jewel-nath/robot-niko/docs/report/robot-niko-report.pdf

Technical report | · Version 1.1 | · October 2026

## Robot Niko: A Life-Size 3D-Printed Humanoid Assistant on a Raspberry Pi

System Design and Build

Jewel Nath¹,2
, Shanjit Mondol²

, Tousif Bin Parves²

, Md Mohiuddin Khan Mahin² ,
Anik Chakraborty²

1

Independent researcher, Dhaka, Bangladesh 2Quanta Robotics, Comilla University, Cumilla, Bangladesh Jewel Nath: ORCID 0009-0002-6609-6378 (https://orcid.org/0009-0002-6609-6378) · Code: https://github.com/jewel-nath/robot-niko

Licence: CC BY 4.0 (https://creativecommons.org/licenses/by/4.0/)

Abstract
Niko is a life-size humanoid assistant built in 2022 by Quanta Robotics, a student robotics team at Comilla University, at the FabLab of the Deputy Commissioner’s Office in Cumilla, Bangladesh. Its body follows InMoov, the open-source 3D-printed humanoid: a head, torso, two arms and two five-fingered hands, on a stand over a wheeled base.

Where InMoov is usually run by Arduino boards and the MyRobotLab framework, Niko runs from a single Raspberry Pi 4 with its own Python software. Two PCA9685 boards drive its 27 servos, addressed as one set of channels and moved through a library of gestures written as timed sequences of joint angles. A wake word, “Hey Niko”, runs on the robot; an online assistant transcribes speech; and Niko answers questions about itself and its host from its own bank (51 questions in 152 phrasings in the published code), in its own voice, its jaw moving as it speaks. A camera lets it turn its head toward a face, and recognise people it has been taught, greeting each one by name with a handshake.

Niko was launched in public on 6 December 2022, and was reported by six news outlets and interviewed on national television. This report describes its mechanical build, electronics, software architecture, motion, voice and vision, documents the behaviours shown on video, and sets out the lessons and the next steps.

Keywords: humanoid robots, social robots, InMoov, 3D printing, Raspberry Pi, servo control, wake word, face recognition, human–robot interaction.

### 1 Introduction

Robots that meet people face to face, greet them and answer their questions are an established line of research in social robotics [1, 2]. A robot receptionist that greets visitors and talks with them [3] and mass-produced humanoids such as NAO and Pepper [4, 5] have shown what such robots can do, but commercial platforms remain out of reach for most student teams.

Open-source, 3D-printed designs have changed that. InMoov [6] and Poppy [7] publish every part of a

Robot Niko: system design and build | Technical report, v1.1, October 2026

humanoid body, printable on a home printer. A body, however, is only half of a robot: it still needs the electronics and software that make it see, speak and move.

Niko was built to show that a student team could take an open design to a working, life-size assistant in under a year, with one low-cost computer and its own software. Its job was to greet visitors to the FabLab, answer their questions about the robot and its host, and recognise the people it knows (Fig. 1).

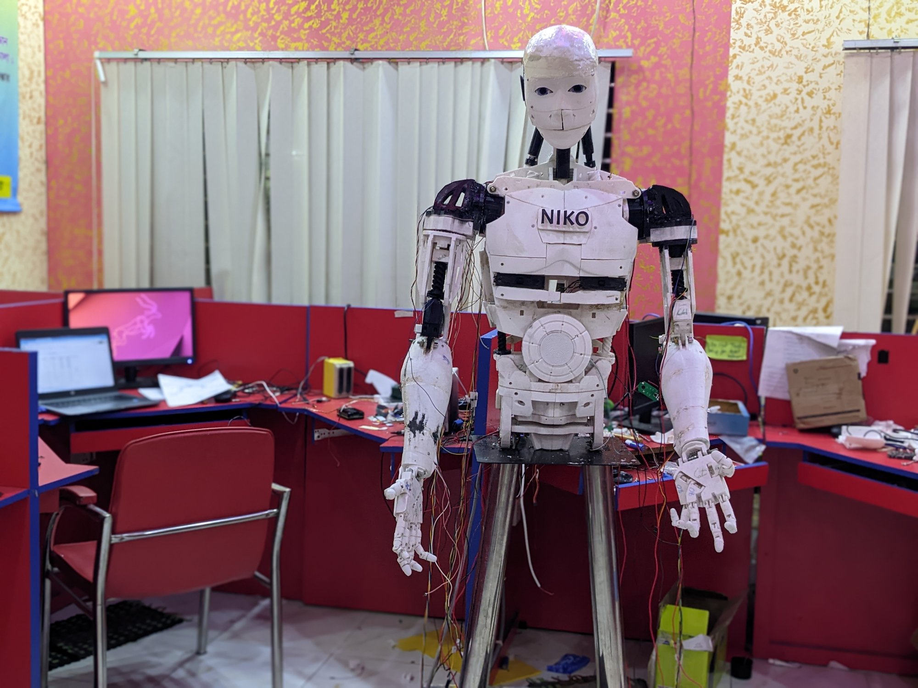
[picture p14: figure]
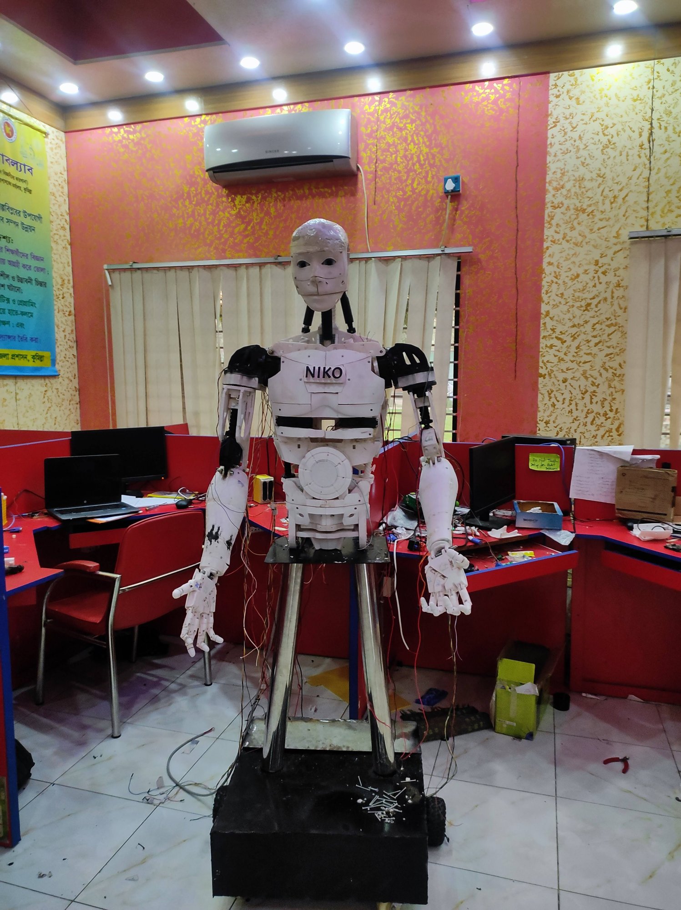
[picture p15: figure]

Figure 1: Niko, finished, on 29 November 2022: the InMoov head, torso, arms and hands on a metal stand (left), and the stand on its wheeled base in the FabLab (right).

This report describes Niko as built, and contributes:

1. a complete InMoov upper body built and run from a single Raspberry Pi, in Python, in place of the usual Arduino boards and MyRobotLab (Sections 4–6);
2. a motion layer that drives 27 servos on two boards as one set of channels, with a library of gestures, from a handshake to counting on its fingers (Section 7);
3. a voice pipeline that combines an on-device wake word, an online assistant and Niko’s own bank of answers, with a jaw that moves as it speaks (Section 8);
4. vision that turns the head toward a face and greets known people by name with a handshake (Section 9);
5. the behaviours shown on video, and the open source code, under the MIT licence; files derived from other projects keep their own licences [8] (Section 10).

Results at a glance

What Niko does | How | Evidence
Follows a face with its head | OpenCV face detection steers the head servo | shown on video
Greets people by name | face recognition, then a spoken greeting and a handshake | shown on video
Holds spoken conversations | wake word, online assistant, its own question bank | shown on video
Introduces itself | a launch speech in seven parts | shown on video
Moves on its wheeled base | a two-motor base under the stand | shown on video
Moves 27 joints | head, eyes, jaw, shoulders, arms, wrists and fin- gers | in the code
Makes hand gestures | handshake (used in greetings); thumbs up, point- ing, counting and more in the library | in the code
Starts by itself | a systemd service starts and restarts it | in the code

Videos recorded on 6 and 7 December 2022 at the FabLab; two are public: the head following a face (https://youtu.be/6iEj3AY1AlA) and Niko introducing itself. (https://youtu.be/Iotg0E8AKoU)

### 2 Related Work

Social robots. Fong et al. survey robots built to interact with people [1], and Breazeal sets out what makes a robot sociable [2]. Gockley et al. placed a robot receptionist with a scripted character in a university building, for long-term interaction with the people who passed it [3]. Niko shared that setting: it lived in one place, greets the people it knows and answers questions about its host.

Humanoid platforms. NAO [4] and Pepper [5] are the best-known commercial humanoids for interaction, and iCub [9] is an open platform for research in embodied cognition. InMoov [6], begun by Gaël Langevin in 2012, and the Poppy project [7] made life-size and smaller humanoids printable at home. In-Moov is usually run by Arduino boards under MyRobotLab [10]; Niko keeps InMoov’s body and replaces its control with a Raspberry Pi and its own code.

Perception. Niko’s face detector is the boosted cascade of Viola and Jones [11], as implemented in OpenCV [12]. Its face recognition uses the face_recognition library [13], built on dlib [14]: faces are aligned with landmarks found by regression trees [15], encoded by a residual network [16] into an embedding in the spirit of FaceNet [17], and classified by nearest neighbours [18] with scikit-learn [19].

Voice. The voice program began from GassistPi [20], an open voice assistant for single-board computers, and uses Picovoice’s Porcupine [21] for an on-device wake word.

### 3 System Overview

Fig. 2 shows the whole robot. A Raspberry Pi 4 runs every program. It drives the servos over I²C through two PCA9685 boards, hears and speaks through a USB sound card, sees through a USB camera on the chest, and signals its state with two lights. Online services, reached over the internet, transcribe speech

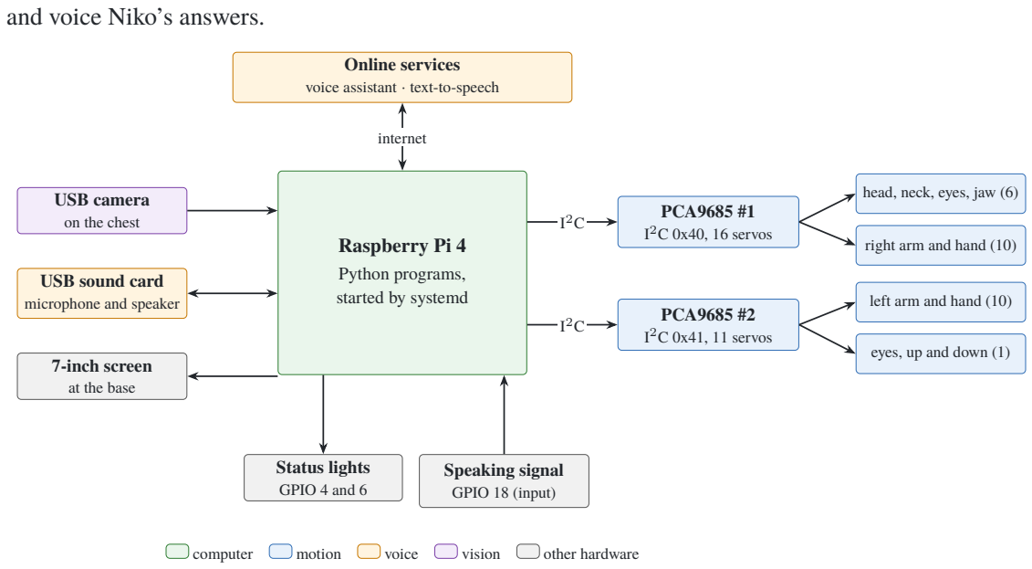
[picture p16: figure]
and voice Niko’s answers.; Raspberry Pi 4; Python programs, started by systemd; Online services voice assistant · text-to-speech; USB camera on the chest; USB sound card microphone and speaker; 7-inch screen at the base; PCA9685 #1; 2C 0x40, 16 servos; PCA9685 #2; 2C 0x41, 11 servos; head, neck, eyes, jaw (6); right arm and hand (10); left arm and hand (10); eyes, up and down (1); Status lights GPIO 4 and 6; Speaking signal GPIO 18 (input); internet; computer; motion; voice; vision; other hardware

Figure 2: System overview. One Raspberry Pi (green) runs the programs; two PCA9685 boards
drive the 27 servos (blue); voice (orange) and vision (purple) devices connect over USB.

The design rests on two choices. First, one computer does everything: there is no microcontroller between the Pi and the servos, only the PCA9685 boards, which generate the pulses on their own once set. Second, the question bank is kept out of the code, in a YAML file: teaching Niko a new answer is an edit to a file, not to the program. The servo map, the channel and starting angle of every joint, is written down in a second YAML file, and the moves use the same numbers.

### 4 Mechanical Build

Niko is InMoov’s head, torso, arms and hands [6]. InMoov’s parts are designed to print on a printer with a 12 × 12 × 12 cm bed; its fingers are pulled by tendons from servos in the forearm. Niko’s eyes move in two axes, its jaw opens and closes, its neck is moved by three servos, and each arm has a shoulder, an omoplate (shoulder blade), an arm rotation, a bicep, a wrist and five fingers. The upper body stands on a metal stand, and the stand on a wheeled base with two motors.

In August 2022 the team assembled a 3D model of Niko from InMoov’s parts in Blender, with “NIKO” on its chest, and posed its joints. The first printed parts in the photos date from mid-August, and the robot was assembled in November (Figs. 3 and 4).

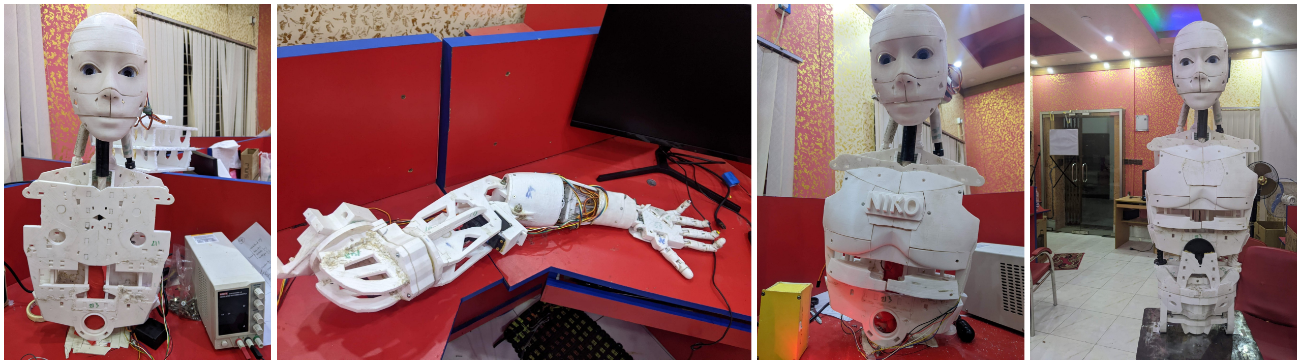
[picture p17: figure]

Figure 3: The build in November 2022, in order: the head on its frame, its eyes in (2 November); one arm and hand, printed and wired (2 November); the head on the chest, “NIKO” printed on it (8 November); the head on the assembled torso (23 November).

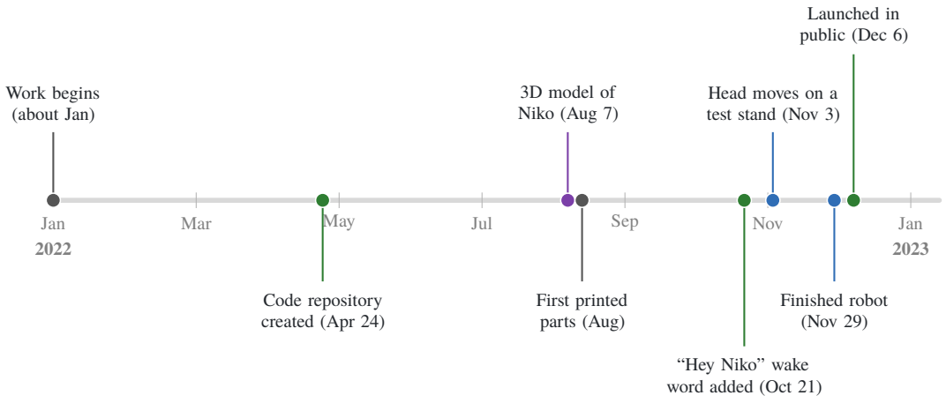
[picture p18: figure]
Jan; Mar; May; Jul; Sep; Nov; Work begins (about Jan); 3D model of Niko (Aug 7); Head moves on a test stand (Nov 3); Launched in public (Dec 6); Code repository created (Apr 24); First printed parts (Aug); “Hey Niko” wake word added (Oct 21); Finished robot (Nov 29)

Figure 4: Niko in 2022, from the first work to the public launch, from the dated photos, videos and code history.

Author contributions. Jewel Nath co-founded Quanta Robotics, led Niko’s programming and wrote most of its code, 3D-printed and assembled its body, tuned its 27 servos, planned its arm motions as servo sequences, and wrote this report. Shanjit Mondol, Tousif Bin Parves, Md Mohiuddin Khan Mahin and Anik Chakraborty built Niko as members of the team; Tousif Bin Parves, Md Mohiuddin Khan Mahin and Anik Chakraborty also contributed to its code.

### 5 Electronics

Table 1 lists the main parts. The 27 servos are split over two PCA9685 boards [22] on the Pi’s I²C bus 1, at addresses 0x40 and 0x41. Each board has 16 channels of 12-bit PWM; the software sets both to 60 Hz. The first board drives the head and the right arm, the second the left arm and the eyes’ tilt (Fig. 5).

Table 1: Main parts, from the code, the setup scripts and the build photos.

Part | Role
Raspberry Pi 4 | runs every program; Python, started by systemd
2 × PCA9685 | 16-channel, 12-bit PWM boards at 0x40 and 0x41, set to 60 Hz; 27 channels used
27 servos | head 1, neck 3, eyes 2, jaw 1; per arm: shoulder, omoplate, rotation, bicep, wrist and 5 fingers
USB camera | on the chest; face following and recognition
USB sound card | microphone and speaker, shared by every program through ALSA’s dsnoop and dmix
Status lights | listening (GPIO 4) and speaking (GPIO 6)
Speaking signal | GPIO 18, an input the code reads as “Niko is speaking”; while it is high, the jaw moves
7-inch screen | at the base, showing the camera view
Wheeled base | two motors under the stand

NIKO

Head
11 head rotation | 90◦
12 neck | 30◦
13 neck, right | 100◦
14 neck, left | 85◦
10 eyes, side to side | 90◦
26 eyes, up and down 120◦
15 jaw | 70◦

Right arm and hand
0 shoulder | 90◦
1 omoplate | 90◦
2 arm rotation 90◦
3 bicep | 90◦
4 wrist | 90◦
5–9 five fingers | 0◦

Left arm and hand
16 shoulder | 90◦
17 omoplate | 100◦
18 arm rotation 45◦
19 bicep | 90◦
20 wrist | 90◦
21–25 five fingers | 0◦
board 1 (0x40), channels 0–15 | board 2 (0x41), channels 16–26
channel joint | starting angle

Figure 5: The servo map: every joint’s channel and starting angle, as set in config/servo-configuration.yaml. Board 1 (blue) drives the head and the right arm; board 2 (teal) the left arm and the eyes’ up-and-down axis.

### 6 Software Architecture

Niko’s software is Python on the Raspberry Pi (Fig. 6). A systemd service starts the voice program, main.py, at boot and restarts it if it stops; secrets, such as the wake-word engine’s access key, are read from a file outside the repository. The voice program runs the assistant’s event loop, with the wake-word detector on its own thread, the jaw on its own process, and a headless Chromium for Niko’s voice.

The vision programs and the launch speech are started on demand, and draw on a common set of modules: move.py for the servos, movement/ for the gestures, indicator.py for the lights and the talk modules for speech. Installer scripts set up the system packages, a Python virtual environment, the sound card and

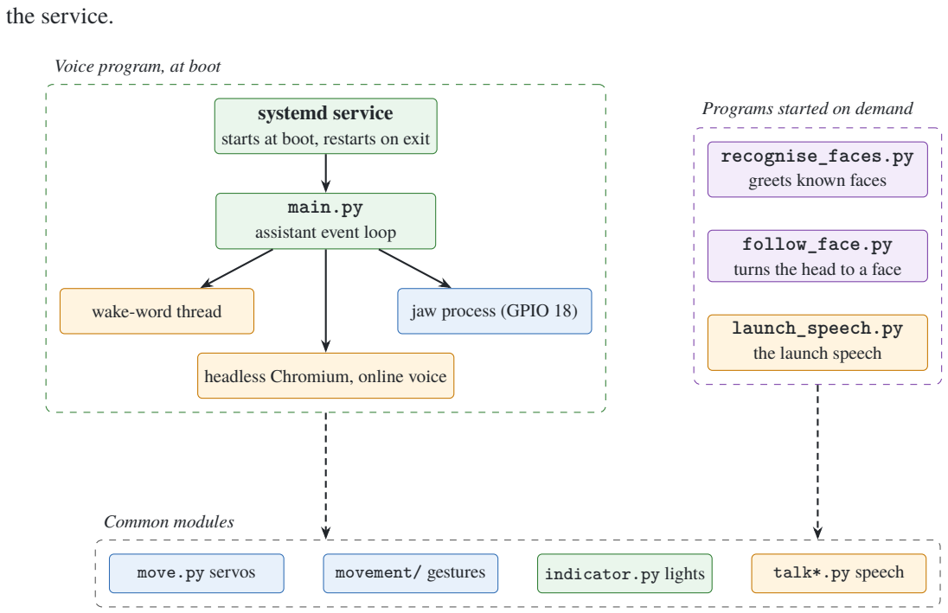
[picture p19: figure]
the service.; Voice program, at boot; Programs started on demand; Common modules; systemd service starts at boot, restarts on exit; main.py assistant event loop; wake-word thread; jaw process (GPIO 18); headless Chromium, online voice; recognise_faces.py greets known faces; follow_face.py turns the head to a face; launch_speech.py the launch speech; move.py servos; movement/ gestures; indicator.py lights; talk*.py speech

Figure 6: The software: the voice program, started at boot (left); the programs started on demand (right); and the modules they draw on (bottom).

The servo map is loaded once, at start; if the file is found empty, move.py restores it from a backup copy before going on.

### 7 Motion

### 7.1 From an angle to a pulse

Every move goes through one function, servoMove(n, angle) (Fig. 7). It takes a channel from 0 to 26 and an angle from 0 to 180◦
, maps the angle linearly to 100–600 counts of the PCA9685’s 4096-count cycle, and writes it to board 1 for channels below 16, or to channel n − 16 of board 2 otherwise. The rest of the code never needs to know which board a joint is on.

Joint angle
θ = 0–180◦

servoMove(n, θ)
c = 100 +

500
180 θ

PCA9685
channel n mod 16,
12-bit, 60 Hz

Servo
pulse c × 4.07 μs

I

2C

n < 16: board 0x40; n ≥ 16: board 0x41

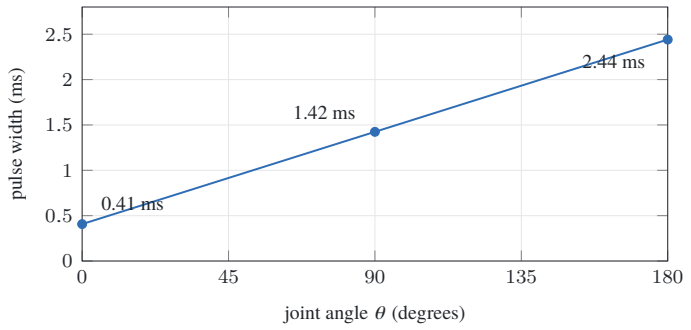
[picture p20: figure]
joint angle θ (degrees); pulse width (ms)

Figure 7: Top: one call moves any joint. Bottom: the pulse width this gives at 60 Hz, from 0.41 ms at 0

◦

to 2.44 ms at 180◦
, worked out from the code’s mapping.

### 7.2 Gestures as timed sequences

Each gesture is a short Python function that steps one or more joints through angles with pauses between them. Most arm moves step one degree every 0.1 s, about 10◦
/s as commanded; a few, such as the arm poses for counting, go straight to their angles. The fingers close and open in a single sweep. Moves of both arms together, such as raising both shoulders, step the two sides in one loop.

The handshake (Fig. 8) shows the method. Niko reaches out with its right arm, turns its wrist, closes its fingers halfway for two seconds, opens them, and draws back, in about 18.5 s as programmed. The library also holds a full and a half grip, thumbs up, pointing, a two-finger sign, a thumb-and-index sign, counting by raising chosen fingers, head turns and eye movements (Appendix, Fig. 13).

0 | 2 | 4 | 6 | 8 | 10 | 12 | 14 | 16 | 18

0

30

60

90

120

150

180 | reach out | hold | release and return

time (s)

commanded angle (degrees)

omoplate (1) | bicep (3) | wrist (4) | fingers (5–9)

Figure 8: The handshake as programmed: commanded angles of the right arm’s omoplate, bicep, wrist and fingers over time, starting from the servos’ starting angles.

### 8 Voice

### 8.1 One exchange

Niko listens all the time for its wake word, “Hey Niko”, with a custom Porcupine model [21] that runs on the Pi; the online assistant’s microphone stays muted until then. On the wake word, it plays a chime, lights its listening light, and hands the microphone to the online assistant, which transcribes the question (Figs. 9 and 10).

The transcript is then compared with Niko’s own question bank. If any of its phrasings appears in what was said, Niko stops the assistant and gives its own answer; if not, the online assistant answers. After each turn the microphone is muted again, and Niko goes back to waiting for its name.

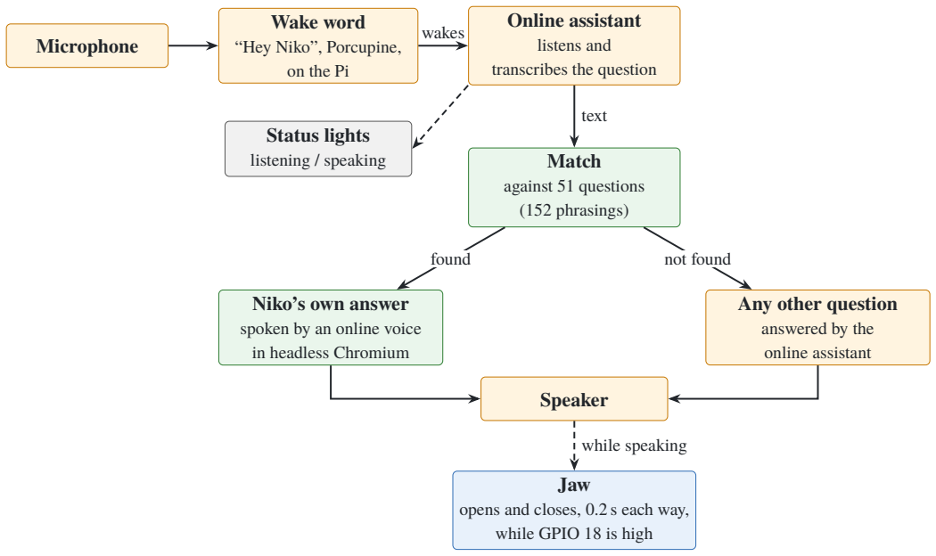
[picture p21: figure]
Microphone; Wake word “Hey Niko”, Porcupine, on the Pi; Online assistant listens and transcribes the question; Match against 51 questions (152 phrasings); Niko’s own answer spoken by an online voice in headless Chromium; Any other question answered by the online assistant; Speaker; Jaw opens and closes, 0.2 s each way, while GPIO 18 is high; Status lights listening / speaking; wakes; text; found; not found; while speaking

Figure 9: One spoken exchange. The wake word runs on the Pi; the question is matched against Niko’s own question bank, and anything else goes to the online assistant.

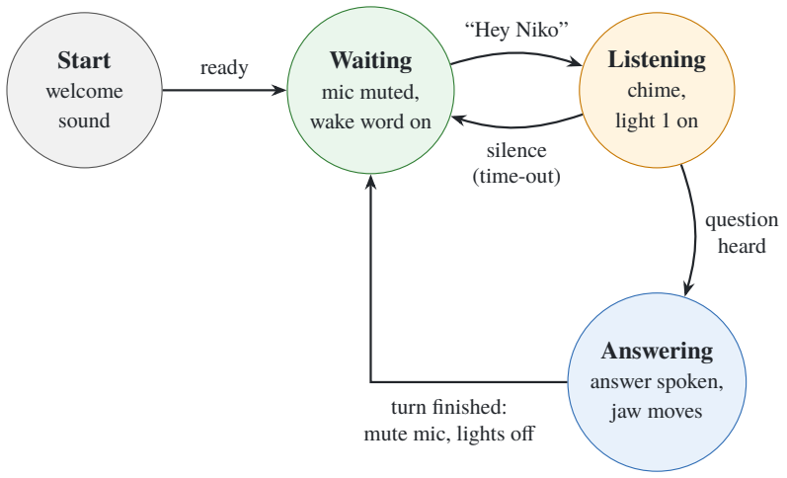
[picture p22: figure]
Start welcome sound; Waiting mic muted, wake word on; Listening chime, light 1 on; Answering answer spoken, jaw moves; ready; “Hey Niko”; question heard; turn finished: mute mic, lights off; silence (time-out)

Figure 10: The conversation loop, driven by the assistant’s events.

### 8.2 Niko’s own answers

The question bank in the published code, config/conversation.yaml, holds 51 questions (trimmed in 2026 from the 66 of December 2022), each in up to 15 phrasings, 152 in all, so that “What is your name”, “who are you” and “your name” all reach the same answer. The questions cover who Niko is, who made it and how, where it was built, and its host, the FabLab and the Deputy Commissioner’s Office. Matching ignores letter case; in the published code the first question that matches wins, so each turn gets one answer.

### 8.3 Niko’s voice and its jaw

Niko’s answers are spoken by an online text-to-speech voice, driven in a headless Chromium through Selenium: the page is opened once, at start, so each answer only fills in the text and presses play. The greetings and the launch speech use gTTS [23], lowered in pitch with SoX. The team tried several other ways to listen and to speak before settling on these (Appendix, Fig. 14).

The jaw moves on its own process. While the speaking signal on GPIO 18 is high, it moves between 110◦ (open) and 70◦
(closed), holding each for 0.2 s, so Niko’s mouth moves as it talks.

### 9 Vision

### 9.1 Following a face

follow_face.py reads the chest camera, finds faces with OpenCV’s frontal-face cascade [11, 12], and turns the head toward each one. The head angle is a linear function of where the face is in the picture: θ = 90◦ + (x − 250)/12, where x is the left edge of the face’s box in pixels (Fig. 11). A face near the middle of the picture keeps the head straight; a face at the edge turns it by up to about 20◦ one way and 30◦
the other, after which Niko pauses for 0.1 s before looking again. The rule is simple: the camera is fixed on the chest, so the picture does not move as the head turns, and one fixed mapping is enough.

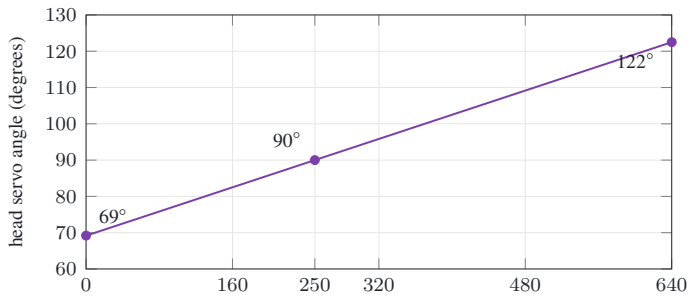
[picture p23: figure]
head servo angle (degrees)

left edge of the face box, x (pixels)

Figure 11: The head-turn rule: the head servo’s angle against the position of the face, assuming a 640-pixel-wide picture (the code does not set the size).

### 9.2 Recognising and greeting people

Each person is enrolled once (Fig. 12). capture_faces.py watches the camera, and whenever it sees exactly one face, finds it with dlib’s detector [14], aligns it by its 68 landmarks [15] to a 400-pixel image, and saves every fifth frame: eight photos for training and two for testing. Training turns each photo into the 128-number face encoding of the face_recognition library [13] and fits a k-nearest-neighbour classifier [18, 19], weighted by distance; photos without exactly one face are left out.

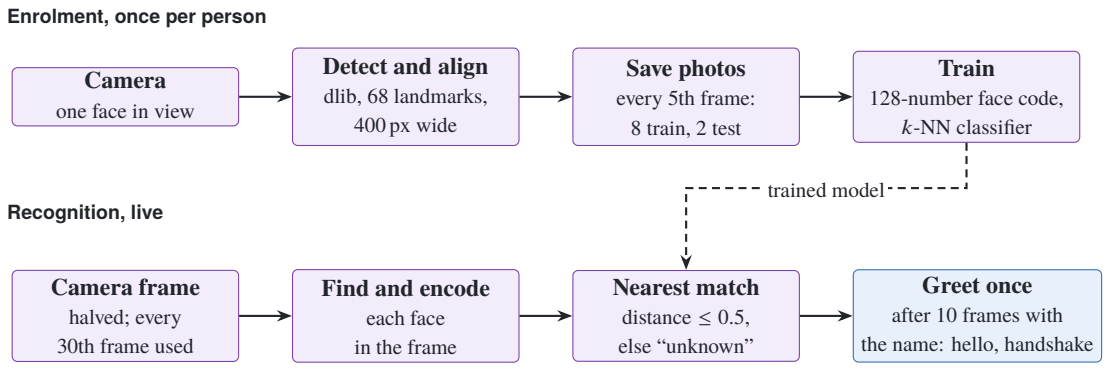
[picture p24: figure]
Enrolment, once per person; Camera one face in view; Detect and align dlib, 68 landmarks, 400 px wide; Save photos every 5th frame: 8 train, 2 test; Train 128-number face code, k-NN classifier; Recognition, live; Camera frame halved; every 30th frame used; Find and encode each face in the frame; Nearest match distance ≤ 0.5, else “unknown”; Greet once after 10 frames with the name: hello, handshake; trained model

Figure 12: Face recognition: enrolment and training (top), and live recognition and greeting (bottom).

At run time, recognise_faces.py halves each camera frame and recognises the faces in every thirtieth, to save processing time. A face whose nearest known face is within a distance of 0.5 is given that person’s name; any other is “unknown”. Once a name has been on screen for ten frames, Niko greets that person: “Hello”, their name, a few friendly words, and a handshake. It greets each person once per run, and has a greeting of its own for its lead programmer.

### 10 Demonstrations

Niko’s abilities were recorded on video at the FabLab in the days around its launch (Table 2).

Table 2: Behaviours recorded on video, and the code behind each.

Date | What the video shows | Code
6 Dec 2022 | The head follows a person walking left and right in front of Niko (53 s; on YouTube) (https://youtu.be/6iEj3AY1AlA) | src/vision/follow_face.py
6 Dec 2022 | Two people come up one at a time; Niko greets each one and shakes their hand (1 min 44 s) | src/vision/recognise_faces.py, src/face_greeting.py
7 Dec 2022 | Two people ask Niko questions, and it answers them (3 min) | src/main.py, config/conversation.yaml
7 Dec 2022 | Niko introduces itself (41 s; on YouTube) (https://youtu.be/Iotg0E8AKoU) | src/launch_speech.py
7 Dec 2022 | Niko drives around the lab on its wheeled base | the base’s two motors

Niko was launched in public at the Deputy Commissioner’s Office in Cumilla on 6 December 2022. Its launch was reported by Dhaka Times 24, Channel 24 Campus, Shomoyer Alo, Kaler Kantho, The Daily Post and Amader Cumilla, and Jewel Nath was interviewed beside Niko by Bangladesh Television (BTV) on 14 December 2022.

### 11 Lessons Learned

Open hardware shortens the road. Building on InMoov let a student team go from a 3D model to a finished life-size humanoid in about four months, and spend its effort on the software that makes the robot useful.

One small computer is enough. A single Raspberry Pi ran the voice, the vision and 27 servos. The PCA9685 boards hold each servo’s pulse on their own, so the Pi only has to send new angles.

Keep the robot’s answers out of its code. With every answer in a YAML file, adding an answer was an edit to a file, not to the program.

A local answer bank keeps the robot in character. An online assistant answers general questions well, but knows nothing about the robot or its host. Matching Niko’s own questions first let it answer questions about itself and the FabLab consistently, in its own voice.

Slow, stepped motion is enough. Moving the arm joints one degree every 0.1 s gave slow gestures without a motion planner, which suits a robot that shakes people’s hands.

### 12 Limitations and Future Work

Niko was built as a working assistant for its launch rather than as an experiment, so its behaviours were recorded on video but not measured. Its gestures run as timed sequences without position feedback, its conversation relies on online services, and its vision programs run separately from its voice program.

The next steps follow from these:

- a conversational assistant built on a large language model, in place of the online assistant, so that Niko can hold open conversations while keeping its own knowledge of itself and its host;

Other directions the team listed in 2022 remain open: speech in Bangla, one program on ROS that joins vision, voice and motion, and mapping with the wheeled base.

### 13 Conclusion

Niko shows that an open, 3D-printed humanoid body and a single Raspberry Pi can become a life-size assistant that hears its name, answers questions in its own voice with a moving jaw, follows a face, recognises the people it knows and shakes their hands. It was built by a student team in 2022, launched in public, and its code is open for others to build on.

### Acknowledgements

The authors built Niko as the team Quanta Robotics. They thank the FabLab of the Deputy Commissioner’s Office, Cumilla, where Niko was built and launched.

Niko’s body is InMoov, by Gaël Langevin (CC BY-NC 3.0). Its voice program and installers started from Shivasiddharth’s GassistPi (MIT, with two conditions); its face recognition from the k-NN camera example of Adam Geitgey’s face_recognition (MIT); and its service installer from Google’s AIY projects (Apache 2.0). Each derived file keeps its original notice.

This report was written with the help of AI assistants, under the first author’s direction; its statements were checked against the code, its history and the dated photos and videos.

### References

[1] T. Fong, I. Nourbakhsh, and K. Dautenhahn, “A survey of socially interactive robots,” Robotics and Autonomous Systems, vol. 42, no. 3–4, pp. 143–166, 2003.
[2] C. Breazeal, “Toward sociable robots,” Robotics and Autonomous Systems, vol. 42, no. 3–4, pp. 167–175, 2003.
[3] R. Gockley, A. Bruce, J. Forlizzi, M. Michalowski, A. Mundell, S. Rosenthal, B. Sellner, R. Simmons,
K. Snipes, A. C. Schultz, and J. Wang, “Designing robots for long-term social interaction,” in Proc. IEEE/RSJ International Conference on Intelligent Robots and Systems (IROS), 2005, pp. 1338–1343.
[4] D. Gouaillier, V. Hugel, P. Blazevic, C. Kilner, J. Monceaux, P. Lafourcade, B. Marnier, J. Serre, and
B. Maisonnier, “Mechatronic design of NAO humanoid,” in Proc. IEEE International Conference on Robotics and Automation (ICRA), 2009, pp. 769–774.
[5] A. K. Pandey and R. Gelin, “A mass-produced sociable humanoid robot: Pepper: The first machine of its kind,” IEEE Robotics & Automation Magazine, vol. 25, no. 3, pp. 40–48, 2018.
[6] G. Langevin, “InMoov: Open-source 3D printed life-size robot,” https://inmoov.fr/, 2012, started in 2012; accessed October 2026.
[7] M. Lapeyre, P. Rouanet, J. Grizou, S. Nguyen, F. Depraetre, A. Le Falher, and P.-Y. Oudeyer, “Poppy project: Open-source fabrication of 3D printed humanoid robot for science, education and art,” in Digital Intelligence 2014, Nantes, France, 2014, https://hal.science/hal-01096338.
[8] J. Nath, T. Bin Parves, M. M. Khan Mahin, and A. Chakraborty, “Robot Niko: Source code,” https://github.com/jewel-nath/robot-niko, (https://github.com/jewel-nath/robot-niko) 2022, MIT licence.
[9] G. Metta, G. Sandini, D. Vernon, L. Natale, and F. Nori, “The iCub humanoid robot: An open platform for research in embodied cognition,” in Proc. 8th Workshop on Performance Metrics for Intelligent Systems (PerMIS), 2008, pp. 50–56.
[10] MyRobotLab, “MyRobotLab: Open-source robotics framework,” https://github.com/MyRobotLab/myrobotlab, (https://github.com/MyRobotLab/myrobotlab) 2026, accessed October 2026.
[11] P. Viola and M. Jones, “Rapid object detection using a boosted cascade of simple features,” in Proc. IEEE Computer Society Conference on Computer Vision and Pattern Recognition (CVPR), vol. 1, 2001, pp. I–511– I–518.
[12] G. Bradski, “The OpenCV library,” Dr. Dobb’s Journal of Software Tools, 2000.

[13] A. Geitgey, “face_recognition: The world’s simplest facial recognition API for Python,” https://github.com/ageitgey/face_recognition, (https://github.com/ageitgey/face_recognition) 2017, MIT licence; accessed October 2026.
[14] D. E. King, “Dlib-ml: A machine learning toolkit,” Journal of Machine Learning Research, vol. 10, pp. 1755– 1758, 2009.
[15] V. Kazemi and J. Sullivan, “One millisecond face alignment with an ensemble of regression trees,” in Proc. IEEE Conference on Computer Vision and Pattern Recognition (CVPR), 2014, pp. 1867–1874.
[16] K. He, X. Zhang, S. Ren, and J. Sun, “Deep residual learning for image recognition,” in Proc. IEEE Conference on Computer Vision and Pattern Recognition (CVPR), 2016, pp. 770–778.
[17] F. Schroff, D. Kalenichenko, and J. Philbin, “FaceNet: A unified embedding for face recognition and clustering,” in Proc. IEEE Conference on Computer Vision and Pattern Recognition (CVPR), 2015, pp. 815–823.
[18] T. M. Cover and P. E. Hart, “Nearest neighbor pattern classification,” IEEE Transactions on Information Theory, vol. 13, no. 1, pp. 21–27, 1967.
[19] F. Pedregosa, G. Varoquaux, A. Gramfort, V. Michel, B. Thirion, O. Grisel, M. Blondel, P. Prettenhofer,
R. Weiss, V. Dubourg, J. Vanderplas, A. Passos, D. Cournapeau, M. Brucher, M. Perrot, and É. Duchesnay, “Scikit-learn: Machine learning in Python,” Journal of Machine Learning Research, vol. 12, pp. 2825–2830, 2011.
[20] Shivasiddharth, “GassistPi,” https://github.com/shivasiddharth/GassistPi, 2020, MIT licence with conditions; accessed October 2026.
[21] Picovoice, “Porcupine: On-device wake word detection,” https://github.com/Picovoice/porcupine, 2022, accessed October 2026.
[22] NXP Semiconductors, “PCA9685: 16-channel, 12-bit PWM Fm+ I²C-bus LED controller, product data sheet,” https://www.nxp.com/docs/en/data-sheet/PCA9685.pdf, 2015.
[23] P. N. Durette, “gTTS: Python library and CLI tool to interface with Google Translate’s text-to-speech API,” https://github.com/pndurette/gTTS, 2022, accessed October 2026.

### A Additional Material

thumb | index | middle | ring | little | wrist
Open hand | –
Grip | –
Half grip | –
Thumbs up | 170◦
Pointing | 90◦
Two fingers | 90◦
Thumb and index | 0

◦

Counting | any chosen fingers open, the rest closed, arm raised
open | closed | half closed – wrist left where it was

Figure 13: The hand poses in the gesture library, as programmed for the right hand (src/movement/right_hand.py). The left hand uses the same finger patterns, but its grips hold the thumb at 70◦ and its wrist angles differ. A finger at 0◦

is open and at 180◦
closed.

Listening, tried

a web speech page in Chrome, through Selenium

the SpeechRecognition library

Vosk, fully offline

Used: a Porcupine wake word, then the online assistant

Speaking, tried

four online voices, through Selenium

pyttsx3, offline

Google Translate’s voice, from a shell script

Used: an online voice for answers; gTTS, pitched lower, for greetings and the speech

Figure 14: Ways to listen and to speak tried in 2022 (experiments/), and what the finished robot uses.

Table 3: The repository.

Folder | Holds
src/ | the voice program, the launch speech, and the modules they use
src/movement/ | the gestures of the head, eyes, arms, hands and wheels
src/vision/ | face following, face recognition and face enrolment
config/ | the servo map and the question bank (YAML)
assets/ | sounds, the wake-word model and the face models
scripts/ | the installers and the sound card setup
systemd/ | the service that starts Niko at boot
experiments/ | the first listening, speaking, servo and motor tests of 2022
docs/ | photos, videos, this report and its diagrams
