jewel-nath/robot-niko/docs/diagrams/robot-niko-angle-to-pulse.pdf

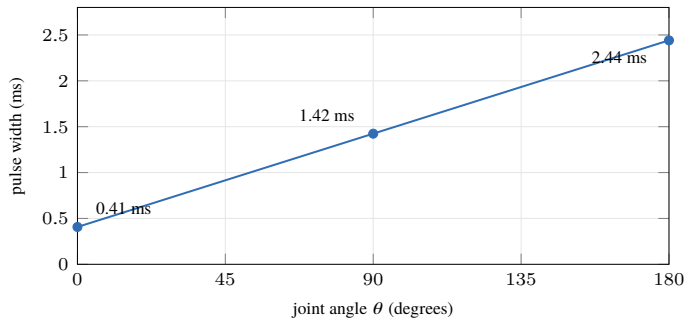
[picture p25: figure]
joint angle; θ (degrees); pulse width (ms)
