jewel-nath/robot-niko/docs/diagrams/robot-niko-follow-face.pdf

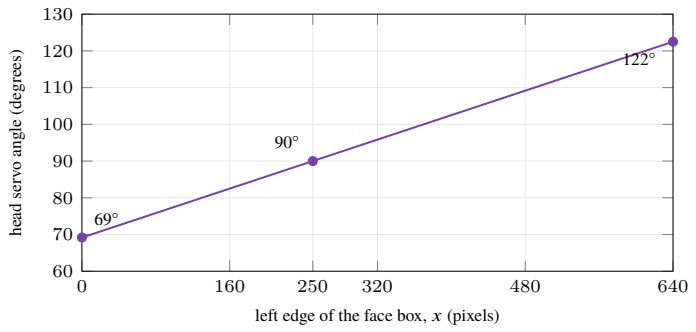
[picture p26: figure]
left edge of the face box,; x (pixels); head servo angle (degrees)
