jewel-nath/robot-niko/cad/1-31 Head/30 TopskullLeftV4.stl

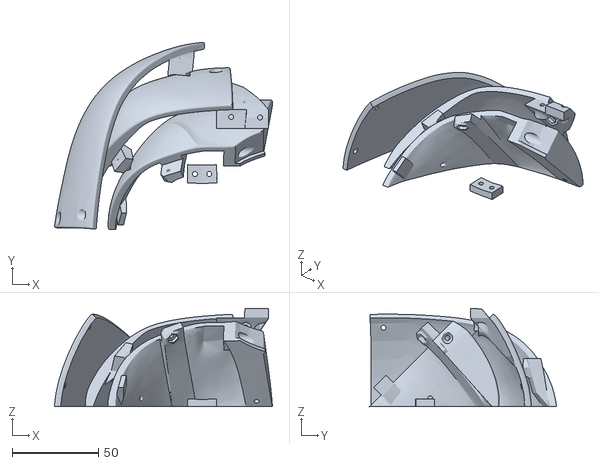
[picture p27: CAD file, 2026-10-30]
cad/1-31 Head/30 TopskullLeftV4.stl
126.3 x 108.4 x 56.9
