jewel-nath/robot-niko/cad/29-66 Neck/NeckV2.stl

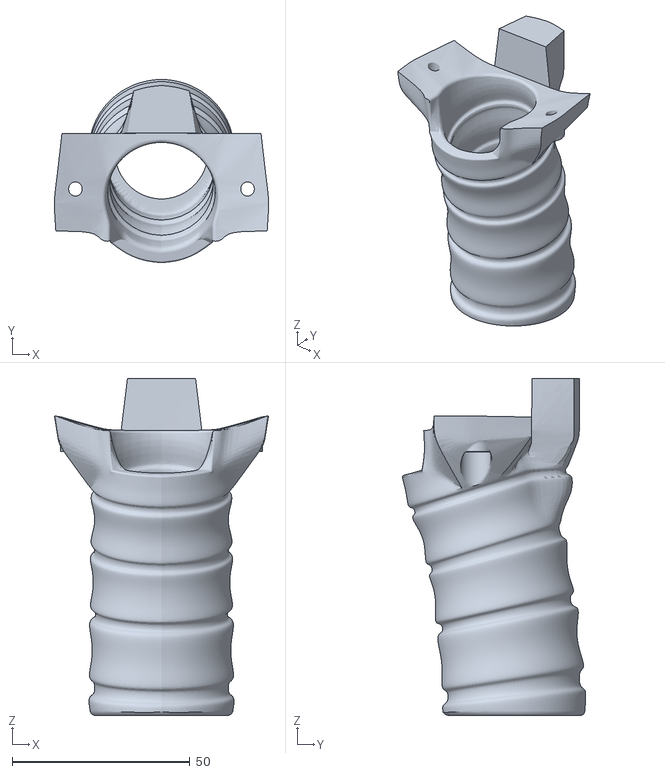
[picture p28: CAD file, 2026-10-30]
cad/29-66 Neck/NeckV2.stl
60.3 x 51.6 x 94.9
