jewel-nath/robot-niko/cad/AI3MSPRO_7InchTFTFrame.stl

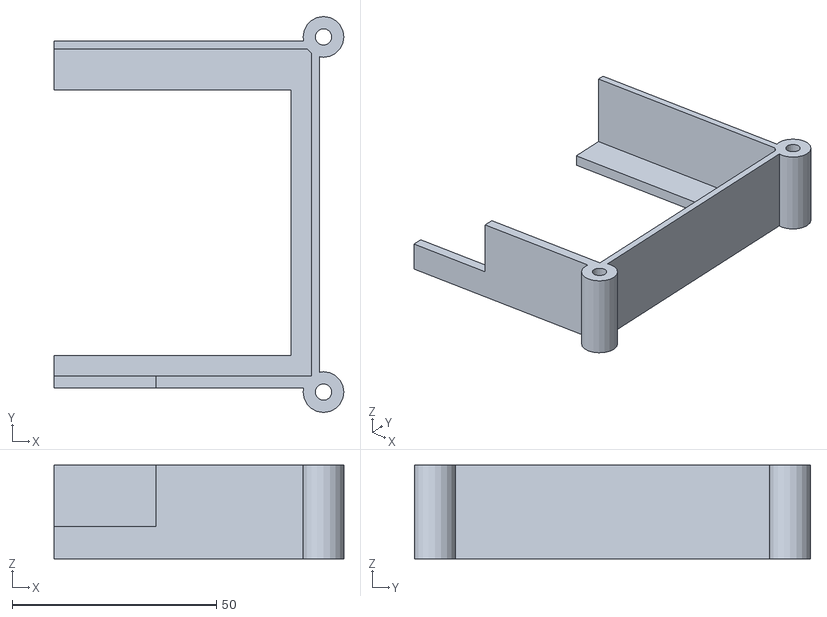
[picture p29: CAD file, 2026-10-30]
cad/AI3MSPRO_7InchTFTFrame.stl
71.0 x 97.0 x 23.0
