jewel-nath/robot-niko/cad/1-31 Head/SideHearV3.stl

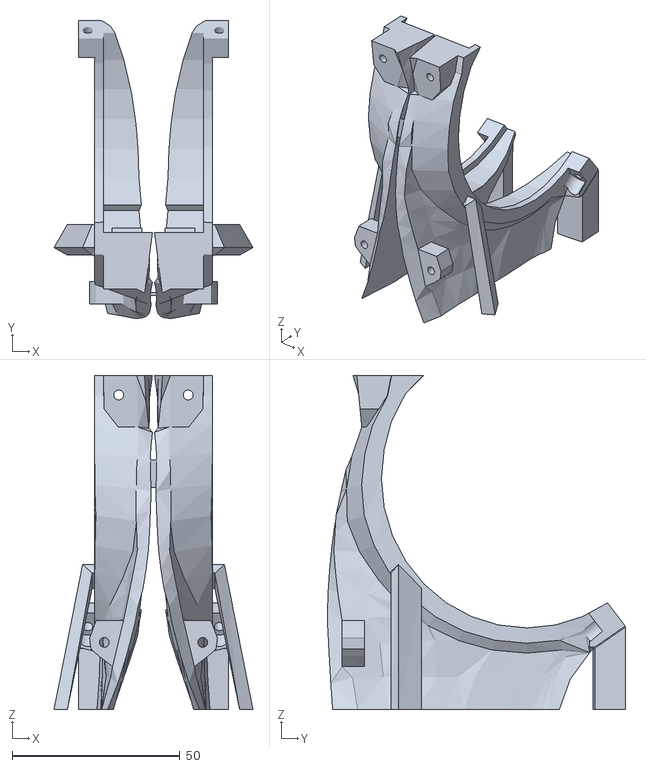
[picture p30: CAD file, 2026-10-30]
cad/1-31 Head/SideHearV3.stl
59.3 x 88.7 x 99.5
