jewel-nath/robot-niko/(list of files, cad)

Other CAD files:
cad/1-31 Head/31 TopskullRightV4.stl
