jewel-nath/robot-niko/docs/diagrams/robot-niko-system-overview.pdf

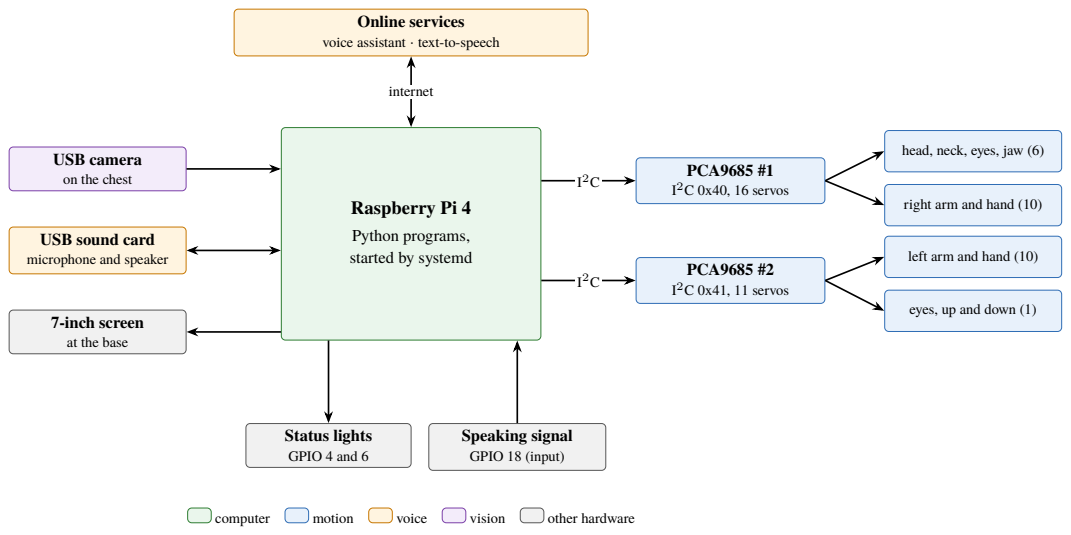
[picture p31: page 1]
PCA9685 #1; 2C 0x40, 16 servos; PCA9685 #2; 2C 0x41, 11 servos; Status lights GPIO 4 and 6; Speaking signal GPIO 18 (input); internet; computer; motion; voice; vision; other hardware

Online services
voice assistant · text-to-speech

head, neck, eyes, jaw (6)

USB camera
on the chest

Raspberry Pi 4
Python programs,
started by systemd

right arm and hand (10)

USB sound card
microphone and speaker

left arm and hand (10)

eyes, up and down (1)

7-inch screen
at the base
