jewel-nath/robot-niko/docs/diagrams/robot-niko-face-recognition.pdf

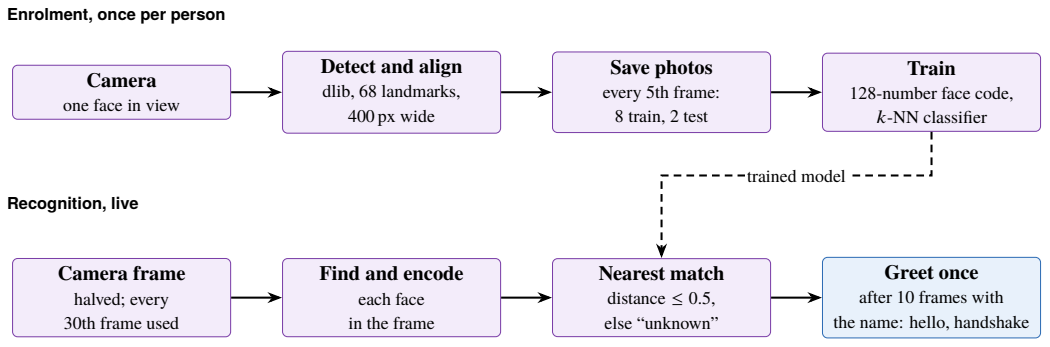
[picture p32: page 1]
Save photos every 5th frame: 8 train, 2 test; Train; Recognition, live; Camera frame halved; every 30th frame used; Nearest match distance ≤ 0.5, else “unknown”; trained model

Enrolment, once per person

Detect and align
dlib, 68 landmarks,
400 px wide

Camera
one face in view

128-number face code,
k-NN classifier

Find and encode
each face
in the frame

Greet once
after 10 frames with
the name: hello, handshake
