jewel-nath/robot-niko/docs/diagrams/robot-niko-hand-gestures.pdf

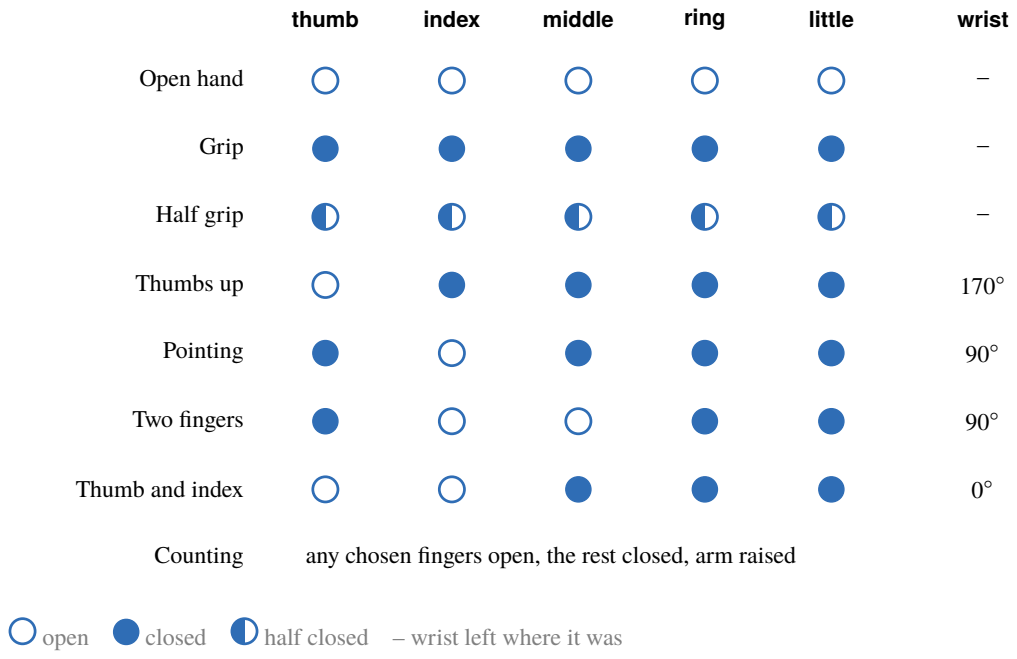
[picture p33: page 1]
thumb; index; middle; ring; little; wrist; Open hand; Grip; Half grip; Thumbs up; Pointing; Two fingers; Thumb and index; Counting; any chosen fingers open, the rest closed, arm raised; open; closed; half closed – wrist left where it was
