jewel-nath/robot-niko/docs/diagrams/robot-niko-servo-map.pdf

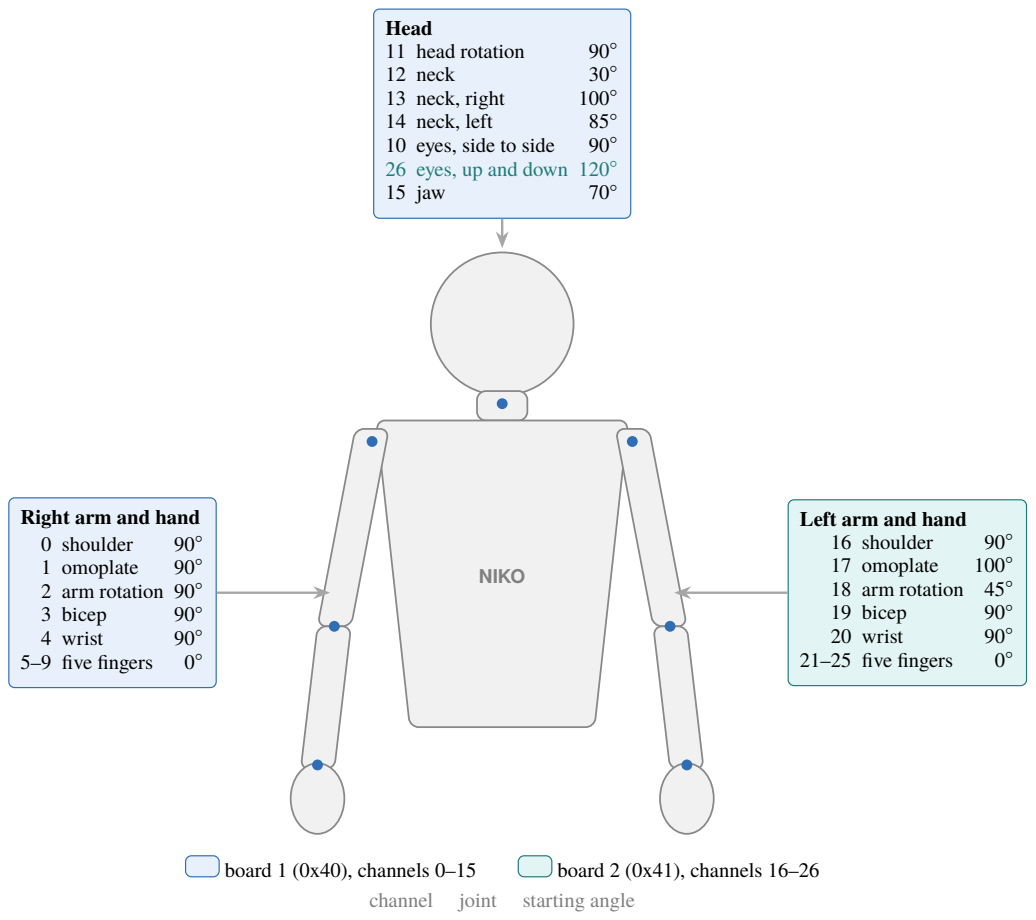
[picture p34: page 1]
NIKO; 11 head rotation; 12 neck; 13 neck, right; 14 neck, left; 10 eyes, side to side; 15 jaw; 0 shoulder; 1 omoplate; 3 bicep; 4 wrist; 5–9 five fingers; 16 shoulder; 17 omoplate; 19 bicep; 20 wrist; 21–25 five fingers; board 1 (0x40), channels 0–15; board 2 (0x41), channels 16–26; channel joint; starting angle

Head
26 eyes, up and down 120◦

Right arm and hand
2 arm rotation 90◦

Left arm and hand
18 arm rotation 45◦
