jewel-nath/robot-niko/docs/diagrams/robot-niko-software-map.pdf

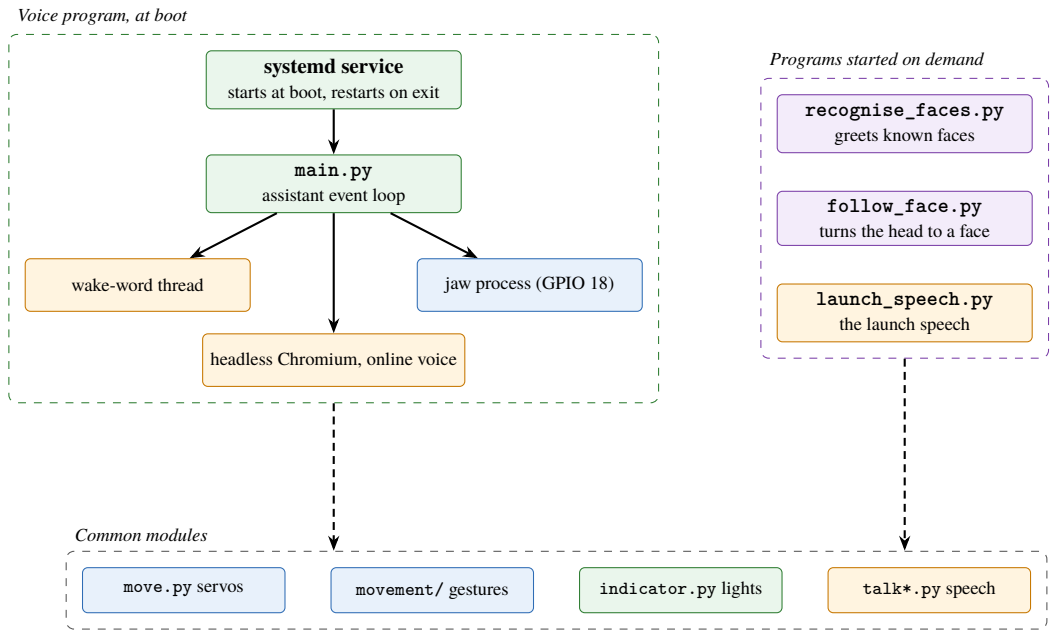
[picture p35: page 1]
Common modules; wake-word thread; jaw process (GPIO 18); move.py servos; movement/ gestures; indicator.py lights; talk*.py speech

Voice program, at boot

systemd service
starts at boot, restarts on exit

Programs started on demand

recognise_faces.py
greets known faces

main.py
assistant event loop

follow_face.py
turns the head to a face

launch_speech.py
the launch speech

headless Chromium, online voice
