jewel-nath/robot-niko/docs/diagrams/robot-niko-voice-pipeline.pdf

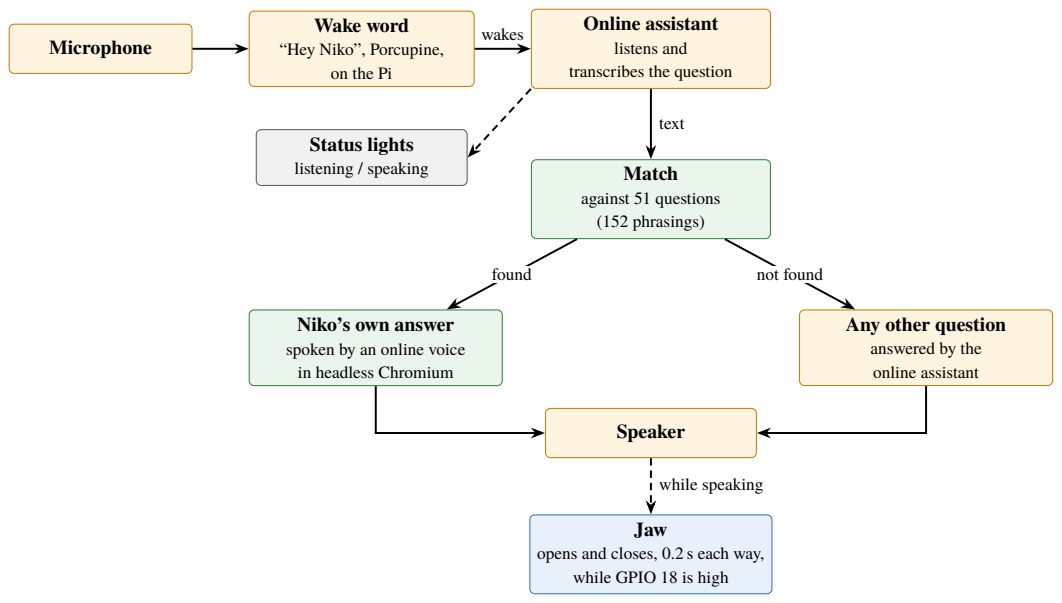
[picture p36: page 1]
Microphone; Match against 51 questions (152 phrasings); Speaker; Jaw; Status lights listening / speaking; wakes; text; found; not found; while speaking

Wake word
“Hey Niko”, Porcupine,
on the Pi

Online assistant
listens and
transcribes the question

Niko’s own answer
spoken by an online voice
in headless Chromium

Any other question
answered by the
online assistant

opens and closes, 0.2 s each way,
while GPIO 18 is high
